VTECEMDEF25-07/F25-07_Open-Source_Hardware_TPM/Testing/README.md

# Testing

Author: Aaron Grossman

- [Hardware](Hardware/README.md): tests and tools that operate on a physical board, plus board-testing procedures.
- [Simulation](Simulation/README.md): HDL testbenches, simulator runners and models.

The FPGA projects remain under `Project/`; reusable RTL remains under `Source Code/`. Keep generated test results in an ignored scratch/output folder.
