VTECEMDEF25-07/F25-07_Open-Source_Hardware_TPM/de1_soc_top.v

// test0_top.v
// modules:
//	test0_top
//
// Authors:
//	Ian Sizemore (idsizemore@vt.edu)
//
// Date: 11/6/25
//
// General Description:
//	Top level module for our physical fpga testing.
//	Other top level modules for different devices will likely look similar.
//	This module targets the Terasic DE0-CV development board.

module de1_soc_top
(
	input		CLOCK_50,
	input		RESET_N,
	output	[9:0]	LEDR,
	
	// the colors indicate the wires used by the FTDI USB-SPI cable
	input /*orange*/GPIO_1_2,	// SPI_clock	[CLK_n]
	input /*yellow*/GPIO_1_3,	// SPI_mosi
	output/*green*/	GPIO_1_4,	// SPI_miso
	input /*brown*/	GPIO_1_5,	// SPI_cs
	input /*grey*/	GPIO_1_6,	// SPI_rst_n
	output/*purple*/GPIO_1_7	// SPI_PIRQ_n
);
	
	wire	pirq_out;
	assign	GPIO_1_7 = pirq_out;
	assign	LEDR[0] = pirq_out;
	
	
	wire	CLOCK_100;
	PLL_100 PLL0( .refclk(CLOCK_50), .rst(~RESET_N), .outclk_0(CLOCK_100) );
	
	tpm_top tpm
	(
		.CLOCK_50(CLOCK_50), .CLOCK_100(CLOCK_100),
		.RESET_n(RESET_N),
		.SPI_CLOCK(GPIO_1_2),
		.SPI_CS_n(GPIO_1_5),
		.SPI_RST_n(GPIO_1_6),
		.SPI_MOSI(GPIO_1_3),
		.SPI_MISO(GPIO_1_4),
		.SPI_PIRQ_n(pirq_out)
	);
	
endmodule
