VTECEMDEF25-07/F25-07_Open-Source_Hardware_TPM/(commit log)

2025-09-19 CDR 2025 Management Module Demo Files
    [c5_pin_model_dump.txt]
2025-09-25 Management module operational states testbench
    Testbench used for validating correct transitions between operational states and 50MHz clock used for simulation.
    [clk.v, tb_managementmodule_opstates.v]
2025-09-26 Update tb_managementmodule_opstates.v with correct timing
    [tb_managementmodule_opstates.v]
2025-09-26 Update tb_managementmodule_startuptypes.v to fix timing
    [tb_managementmodule_startuptypes.v]
2025-09-30 Update management_module.v
    to include changes made while synthesizable testing on DE1-SoC board and added comments for documentation.
2025-09-30 Update and rename c5_pin_model_dump.txt to Management Module/c5_pin_model_dump.txt
    [c5_pin_model_dump.txt]
2025-10-01 Added management module board testing procedures
2025-10-26 Update execution_engine.v to include authorization check for TPM2_HierarchyControl
    Also made adjustments to mode check for failure mode and fixed physical presence check
    [execution_engine.v]
2025-10-30 Update execution_engine.v to fix commandInd typo (should have been commandIndex)
    [execution_engine.v]
2025-10-31 Update execution_engine.v to fix authorization check
    [execution_engine.v]
2025-11-04 Update execution_engine.v to include command_code_tag reg logic and fix early reset of response code
    [execution_engine.v]
2025-11-04 Management module: fixed command code and response code formats, plus added more comments
    [management_module.v]
2025-11-04 Update execution_engine.v to fix response code format
    [execution_engine.v]
2025-11-04 Update execution_engine.v to fix response_length and response_valid resets
    [execution_engine.v]
2025-11-05 Fixed loop on session_error within STATE_SESSION_VALID
    1134
    [execution_engine.v]
2025-11-05 Update execution_engine.v to fix authHierarchy
    [execution_engine.v]
2025-11-07 Fixed unsafe latch behavior warnings.
    [execution_engine.v]
2025-11-08 Fixed state loop in STATE_SESSION_VALID
    [execution_engine.v]
2025-11-10 Update execution_engine.v to fix session response codes
    [execution_engine.v]
2025-11-11 Updated testing, fixed issue in FIFO buffer
    [testbench.c]
2026-02-28 update gitignore
    [c5_pin_model_dump.txt]
2026-03-08 Naming Convention Updates
    To run for I/O simulation, the testbench was updated to have the correct module instantiation and the de1_soc_top file was updated to carry the updated naming convention for inputs and outputs.
    [de1_soc_top.v]
2026-04-28 Changed the symmetric_top.v and aes.v to finalize, created symmetric_demo_top.v to run a demo and confirm FSM structure on the board, and changed tb_test.qsf to make the symmetric module the top leve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
2026-09-30 RNG module added
    [c5_pin_model_dump.txt]
2026-10-23 Add independent DE25 board management and main TPM integration
2026-10-23 Organize DE1 and DE25 targets behind a shared board selector
2026-11-04 fix: use synchronous SPI on DE25 with routed timing validation
2026-11-04 refactor: share one synchronous SPI transport across both boards
2026-11-04 Rename DE25 support folder to Fan Controller
2026-11-04 Organize board projects, shared source and simulations
2026-11-04 WIP: direct-clock SPI transport for 24 MHz validation
2026-11-04 Constrain shared high-speed SPI and record board validation
2026-11-04 Track outstanding board and SPI work at the project root
2026-11-04 Simplify author headers and board readmes; use six build processors
2026-11-04 Use original Terasic DE25 fan example with minimal board integration
2026-11-08 style: apply port naming conventions to current project layout
2026-11-09 Add DE25 USB adapter and Lenovo tester pinout selection
    Add build-time USB adapter and Lenovo Pi tester pin selection, with configuration and wiring documentation.
2026-11-09 Record reviewed DE25 physical SPI results and open high-speed failure
2026-11-09 Integrate SPI command handling with SHA-256 and AES
    Reuse the SPI command and response buffer for TPM2_Hash and
    TPM2_EncryptDecrypt2. Route SHA-256 requests to the shared hash
    engine and return the digest and null validation ticket.
    Parse EncryptDecrypt2 packets, request the key by handle, and
    pass approved jobs to the existing AES-256 CFB controller.
    Return the output data and updated IV over SPI. Keep the AES
    command disabled in the normal FPGA build until key lookup
    and authorization are connected.
2026-11-10 Integrate protected crypto demo and gated SPI buffer lifecycle
2026-11-10 Check independent partial CFB IV in composed SPI demo
2026-11-10 Constrain only the verified asynchronous fresh RNG first sampler D pin
2026-11-10 Wire gated RSA2048 customer route and live hardware telemetry
2026-11-10 Import measured optional raw-source cadence and scope customer sampler timing
2026-11-10 Run fresh original Phase I suites before the customer crypto flow
2026-11-10 Wire dedicated HPS LCD island and preserve separate firmware build evidence
2026-11-10 Add validated COM7 status relay and separate OCRAM build output
2026-11-10 Clarify installed UART driver purge behavior at first boot
2026-11-10 Document hardware-validated RSA2048 customer flow and fallback scope
2026-11-10 Trace LCD startup through counter-independent UART diagnostics
